lawliet206/ROS/frames.pdf

view_frames Result

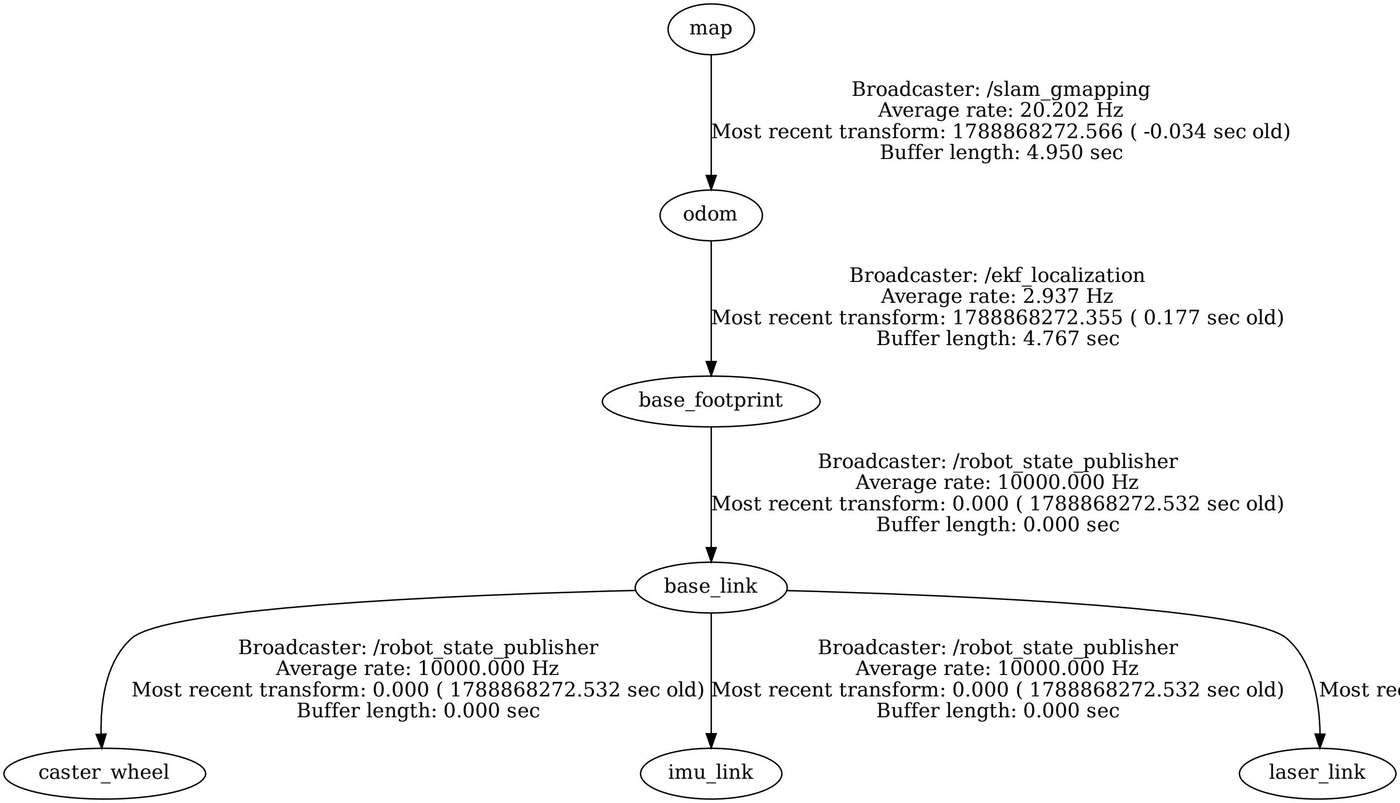
[picture p9: figure]
base_link; caster_wheel; Broadcaster: /robot_state_publisher Average rate: 10000.000 Hz; Buffer length: 0.000 sec; imu_link; laser_link; base_footprint; odom; Broadcaster: /ekf_localization Average rate: 2.937 Hz; Buffer length: 4.767 sec; map; Broadcaster: /slam_gmapping Average rate: 20.202 Hz; Buffer length: 4.950 sec

Most recent transform: 0.000 ( 1788868272.532 sec old)

Most recent transform: 0.000 ( 1788868272.532 sec old)

Broadcaster: /robot_state_publisher Average rate: 10000.000 Hz Most recent transform: 0.000 ( 1788868272.532 sec old) Buffer length: 0.000 sec

Most recent transform: 0.000 ( 1788868272.532 sec old)

Most recent transform: 1788868272.355 ( 0.177 sec old)

Most recent transform: 1788868272.566 ( -0.034 sec old)

Recorded at time: 1788868272.532
