lawliet206/ROS/硬件采购清单.md

# 两轮差速 ROS 机器人 — 硬件采购清单

> ⚠️ **注意：本文档为早期采购参考，部分内容已过时。**
> 电机驱动已从 **BTS7960 更换为 TB6612FNG**（3.3V 逻辑直连 ESP32，见 README「已解决」）；
> 下文架构图中的 BTS7960 请以 TB6612FNG 为准，采购清单已推荐 TB6612FNG。

## 架构概览

```
车载端:
  J1900 ──WiFi/网线──→ PC (你的笔记本, ROS Master)
      │
      └── USB ──→ 激光雷达 (USB转TTL)
      │
      └── USB ──→ ESP32
                        │
                        ├── PWM → TB6612FNG → 左电机 (带编码器)
                        ├── PWM → TB6612FNG → 右电机 (带编码器)
                        ├── PCNT ← 左/右编码器
                        └── I2C ← MPU6050 (IMU)
```

**分工：**
- **PC (ROS Noetic)**：SLAM (gmapping)、move_base 导航、人体跟随算法、ROS Master
- **J1900**：激光雷达驱动、串口桥接（收发 ESP32 数据）、WiFi 中继
- **ESP32**：电机 PID 控制、编码器读取、IMU 读取
- **TB6612FNG**：双路电机驱动（H 桥）

---

## 采购清单（按购买优先级排列）

### 1. 直流编码电机 ×2 【必买】

| 项目 | 规格 |
|---|---|
| 型号 | **JGB37-520** 直流减速电机（带霍尔编码器） |
| 电压 | 12V DC |
| 转速 | **1000 RPM**（对应减速比 **1:10**） |
| 编码器 | 霍尔编码器，AB 双相，**11 PPR**（6 线：电机正负 + 编码器电源正负 + A相 + B相） |
| 轴径 | **6mm D 型轴** |
| 转矩 | 电机本体 0.4 kg·cm × 减速比 10 = 输出轴 **4.0 kg·cm（0.39 N·m）**，够用 |
| 数量 | **2 个**（左右轮各一） |
| 预算 | **~120-160 元**（60-80 元/个） |

> 淘宝搜索词：`JGB37-520 编码电机 12V 1:10` 或 `JGB37-520 1000转`
>
> **务必确认：** ① 带霍尔编码器（11 PPR） ② 减速比 **1:10** ③ 输出轴 ~1000RPM ④ 6mm D 轴 ⑤ 转矩 0.4 kg·cm(电机本体)
> **速度：** 85mm 轮径 × 1000RPM = **4.45 m/s**，远超 2.38 要求。
>
> 常见店铺：龙盛五金、科智等，下单时跟客服确认以上 4 点。

---

### 2. 电机驱动模块 ×1 【必买】

JGB37-520 电机空载电流 ~200mA，堵转 ~2-3A，不需要大功率驱动。

**推荐：TB6612FNG 双路 H 桥 ~20-30 元**

| 项目 | 规格 |
|---|---|
| 型号 | **TB6612FNG** 双路 MOSFET H 桥模块（带底板） |
| 输入电压 | VM = 4.5V~13.5V（电机供电） |
| 逻辑电压 | VCC = 2.7V~5.5V（接 ESP32 3.3V） |
| 每路电流 | 1.2A 连续，峰值 3.2A |
| 控制 | AIN1/AIN2 + PWMA（左）, BIN1/BIN2 + PWMB（右） |
| 特点 | MOSFET 驱动，效率高、不发热、3.3V 直连 ESP32 |
| 数量 | **1 个**（一块驱动两个电机） |
| 预算 | **~20-30 元** |

> 淘宝搜索词：`TB6612FNG 电机驱动模块`
>
> **接线：** 与 L298N 完全相同（IN1/IN2 + PWM 控制），ESP32 固件通用。多一个 STBY 脚拉高到 3.3V 即可。
>
> **注意：** VM 最高 13.5V，3S 电池满电 12.6V，安全范围内。

---

### 3. 轮子 ×2 【必买】

| 项目 | 规格 |
|---|---|
| 类型 | 橡胶/硅胶轮胎 + 塑料/金属轮毂 |
| 直径 | **85mm**（附赠 6mm 黄铜联轴器。配 1:10 电机极速 4.45m/s） |
| 轮毂孔径 | **6mm**（联轴器直接套电机 D 轴） |
| 宽度 | 40-60mm |
| 数量 | **2 个** |
| 预算 | **~40-80 元**（20-40 元/个） |

> 淘宝搜索词：`机器人轮胎 85mm 6mm联轴器`
>
> **速度：** 85mm × 1000RPM(1:10) = **4.45 m/s** > 2.38 ✅
>
> **注意：** 轮径和减速比必须匹配代码，需要改三处：
> 1. **ESP32 固件**：`WHEEL_DIAMETER` → `0.085`，`GEAR_RATIO` → `10.0`
> 2. **serial_bridge**：启动加 `_wheel_dia:=0.085 _gear_ratio:=10.0`
> 3. **仿真 URDF**：`wheelDiameter` → `0.085`

---

### 4. 电池 ×1 【必买】

| 项目 | 规格 |
|---|---|
| 类型 | **3S 航模锂电池（LiPo）** |
| 标称电压 | 11.1V |
| 满电电压 | 12.6V |
| 容量 | **5200mAh ~ 6200mAh** |
| 放电倍率 | ≥25C（5200mAh × 25C = 130A，绰绰有余） |
| 接口 | **XT60 母头**（最通用） |
| 数量 | **1 块**（建议买 2 块，一块充一块用） |
| 预算 | **~100-140 元/块** |

> 淘宝搜索词：`3S 5200mAh 25C 锂电池 XT60`
>
> 常见品牌：Zeee、Ovonic、狮子（Lion Power）、富力。
>
> **续航计算：** 满速运行时电机 ~40W + J1900 5W + 雷达 2W ≈ 47W，11.1V 下 ~4.2A。5200mAh 可跑约 1 小时，远超 8 分钟要求。
>
> **还需要配充电器：**
> - 入门平衡充：**B3 充电器**（20W，慢但便宜）~25 元
> - 推荐平衡充：**B6AC**（80W，带屏幕，多功能）~80 元
> - 淘宝搜 `B6AC 平衡充电器`

> **安全提醒：** 锂电池禁止过充（>4.2V/片）和过放（<3.3V/片）。ESP32 代码里我会加上电压检测和低压报警。充电时人不要离开。

---

### 5. ESP32 开发板 ×1 【必买】

| 项目 | 规格 |
|---|---|
| 型号 | **ESP32-WROOM-32** 开发板（CP2102 或 CH340 串口芯片均可） |
| 主频 | 240MHz 双核 |
| 引脚 | 30 脚或 38 脚均可 |
| 接口 | Micro USB |
| 数量 | **1 块** |
| 预算 | **~20-35 元** |

> 淘宝搜索词：`ESP32 开发板 CP2102` 或 `ESP32-WROOM-32`
>
> 推荐店铺：安信可（原厂）、合宙。买最便宜的开发板即可，不用买带屏幕/摄像头的版本。

---

### 6. IMU 模块 ×1 【必买】

| 项目 | 规格 |
|---|---|
| 型号 | **MPU6050**（6 轴：3 轴加速度 + 3 轴陀螺仪） |
| 接口 | I2C |
| 电压 | 3.3V ~ 5V |
| 数量 | **1 个** |
| 预算 | **~8-15 元** |

> 淘宝搜索词：`MPU6050 模块 GY-521`
>
> 买 GY-521 紫色/蓝色小板即可，最通用。

---

### 7. 降压模块 ×2 【必买】

| 项目 | 规格 |
|---|---|
| 类型 | **DC-DC 可调降压模块** |
| 型号 | LM2596 或 Mini-360（MP1584） |
| 输入 | 4.5V ~ 28V |
| 输出 | 可调，设定为 5V |
| 电流 | ≥3A |
| 数量 | **2 个**（1 个给 J1900 供电，1 个给 ESP32 + 雷达供电） |
| 预算 | **~10-20 元**（5-10 元/个） |

> 淘宝搜索词：`LM2596 降压模块` 或 `mini360 降压模块`
>
> Mini-360 更小更便宜（~3 元/个），但需要焊线。LM2596 带螺丝端子，接线方便。

---

### 8. 底盘材料 【必买】

| 项目 | 规格 |
|---|---|
| 方案 | **亚克力板 双层**，厚 4-5mm，淘宝激光切割 ~40 元 |
| 下层 | **200×160mm**：电机 + 牛眼轮 + 电池 |
| 上层 | **180×140mm**：TB6612FNG + ESP32 + 激光雷达 + J1900 |
| 连接 | 四角 M3 双通铜柱 50mm 连接上下层 |

> 提供 DXF 图纸（`tools/generate_dxf.py` 生成），发给店家即可。
> 淘宝搜索词：`亚克力板定制 激光切割`

---

### 9. 万向从动轮 ×1 【必买】

| 项目 | 规格 |
|---|---|
| 类型 | 金属牛眼轮或小型万向轮 |
| 直径 | 25-40mm（需要垫高到与底盘齐平，底盘 ~5cm 高） |
| 安装 | 螺丝 + **14mm 铜柱垫高**（底盘底面 42.5mm - 牛眼轮 29mm = 差 13.5mm，用 10+4mm(螺母) 铜柱凑） |
| 数量 | **2 个**（车头 1 个，车尾底面 1 个） |
| 预算 | **~10-30 元**（2 个） |

> 淘宝搜索词：`金属牛眼轮 M3`
>
> **你的牛眼轮高 29mm，底盘底面离地 42.5mm，需要用铜柱垫高 14mm。**

---

### 10. 接线配件 【必买】

| 项目 | 规格 | 预算 | 用在哪儿 |
|---|---|---|---|
| 14AWG 硅胶线 红/黑 各 1 米 | 裸线无接头，自己剪长度，焊 XT60 或拧 BTS7960 螺丝端子 | ~10 元 | 电池→开关→BTS7960（大电流） |
| XT60 公头 ×3 | 焊在 14AWG 线端。公头=金属柱外露，接用电设备端 | ~8 元 | BTS7960 电源输入 ×1，降压模块输入 ×1，充电器线 ×1 |
| XT60 母头 ×1 | 焊在 14AWG 线端。母头=孔藏里面，接电池端（电池自带则不用） | ~3 元 | 电池延长线（如需） |
| XT60 一分二并联线 ×1 | 成品线，一头母接电池，分出两个公头 | ~8 元 | 电池一分二：一路→开关→BTS7960，一路→降压模块 |
| 电源开关（带 XT60） ×1 | 串联在电池和 TB6612FNG 之间，关掉即整车断电（不含 J1900/ESP32） | ~10 元 | 电池→开关→TB6612FNG VM |
| 杜邦线 公母 各 20 根 | 预压好插头的信号线，直接插 ESP32/BTS7960 排针 | ~5 元 | 全部信号线：PWM、编码器、I2C |
| 电机固定支架 ×2 | L 型 或 U 型，M3 安装孔 | ~10 元 | 固定 JGB37-520 到板子边缘 |
| 电阻 10kΩ + 1kΩ ×1 套 | 1/4W 碳膜，引脚直插焊接 | ~1 元 | 电池分压电路（电池正→10k→GPIO34→1k→GND） |
| 排针 + 排母 各 1 排 | 2.54mm 间距，焊在 ESP32/驱动板信号口 | ~5 元 | ESP32 GPIO 引出，BTS7960 信号口引出 |
| 热缩管套装 | 各种粗细 | ~5 元 | 包焊点/接线处，绝缘 |
| 尼龙扎带 | 3×100mm | ~3 元 | 线束整理 |
| 3M 双面胶/魔术贴 | 宽 20mm | ~5 元 | 电池固定，MPU6050 固定 |
| M3 双通铜柱套装 | **双通** 6/10/15/20mm + **50mm×4**（连接上下层用）+ M3×10mm 螺丝 30 个 + M3 螺母 20 个 | ~16 元 | 板卡固定 + 双层连接 |
| M3 平垫片 ×20 个 | 外径 7mm，内径 3.2mm | ~3 元 | 螺丝头夹住板子，不会从 5mm 孔滑脱 |
| PH2.0 4P 转杜邦母头 ×2 | 编码器信号线，4P 头插电机排针2/3/4/5（Vcc/A/B/GND） | ~6 元 | 电机编码器 → ESP32 GPIO |
| USB Micro 数据线 ×1 | 必须数据线（4 芯），不能是充电线（2 芯） | ~8 元 | J1900 USB → ESP32 Micro USB |
| **合计** | | **~110 元** |

> **铜柱安装方式（板孔 5mm > 螺丝 3mm，必须垫片！）：**
> ```
>   [板卡]           ← ESP32 / BTS7960
>    ↕ M3 短螺丝
>   [铜柱 双通]
>    ↕ M3×10mm 螺丝
>   [垫片]            ← 外径 7mm > 板孔 5mm
>   [===亚克力板===]
> ```
> 螺丝从下往上穿：螺丝头→垫片→5mm板孔→铜柱。垫片夹紧，不会滑脱。

---

### 11. 激光雷达（先测试 lab 给的）【条件购买】

如果 lab 的雷达是坏的，需要自己买：

| 型号 | 说明 | 价格 |
|---|---|---|
| **YDLIDAR X4** | 10m 测距，360°，ROS 驱动成熟 | ~400 元 |
| **RPLIDAR A1M8** | 12m 测距，360°，ROS 驱动成熟 | ~450 元 |
| 二手 YDLIDAR X2/X4 | 闲鱼上可能有，便宜但风险 | ~200-300 元 |

> 淘宝搜索词：`YDLIDAR X4 激光雷达` 或 `思岚 A1M8`
>
> YDLIDAR X4 性价比更高，驱动成熟，文档齐全。

---

### 12. USB 摄像头（人体跟随用）【可选，先不买】

| 项目 | 规格 |
|---|---|
| 类型 | USB 免驱摄像头 |
| 分辨率 | ≥640×480 |
| 帧率 | ≥30fps |
| 视角 | ≥70° |
| 预算 | **~50-80 元** |

> **策略：** 先用纯激光雷达做人体跟随（不花钱），效果不好再买摄像头做视觉融合。
>
> 淘宝搜索词：`USB摄像头 免驱 广角`

---

## 总预算汇总

| 类别 | 项目 | 金额 |
|---|---|---|
| **必买** | 编码电机 ×2 | 120-160 元 |
| **必买** | TB6612FNG 驱动 | 20-30 元 |
| **必买** | 轮子 ×2 | 40-80 元 |
| **必买** | 3S 锂电池 | 100-140 元 |
| **必买** | B6AC 充电器 | 80 元 |
| **必买** | ESP32 | 20-35 元 |
| **必买** | MPU6050 IMU | 8-15 元 |
| **必买** | 降压模块 ×2 | 10-20 元 |
| **必买** | 底盘 + 牛眼轮 ×2 | 40-75 元 |
| **必买** | 接线配件 | 110 元 |
| | **必买小计** | **~564-766 元** |
| **条件** | 激光雷达（lab 坏时） | 400-450 元 |
| **可选** | USB 摄像头 | 50-80 元 |
| | **最高总计** | **~995-1267 元** |

---

## 省钱的极限方案（去掉摄像头、lab 雷达能用）

**最低花费约 564 元**，就能跑通全部基本任务（建图 + 导航 + 纯激光人体跟随）。

---

## 核对清单（下单前逐项确认）

- [ ] 电机：确认 1000RPM（输出轴）、带霍尔编码器（11 PPR）、减速比 1:10、6mm D 轴
- [ ] 轮子：确认 85mm，附赠 6mm 联轴器
- [ ] 电池：确认 3S XT60 接口
- [ ] 充电器：确认支持 3S 锂电池平衡充
- [ ] ESP32：确认是 CP2102 或 CH340 串口芯片
- [ ] 降压模块：确认输入电压范围覆盖 11.1V（至少 15V 以上耐压）
- [ ] BTS7960：确认是双路红色 PCB
- [ ] XT60 接头数量配对（电池 1 母 + 驱动端 1 公，充电器端看充电器接口）
- [ ] XT60 一分二并联线 + 电源开关（不要省，安全第一）
- [ ] USB 线是数据线，不是充电线

---

## 电压安全红线（必读！烧了不赔）

**每个元件能承受的最高电压：**

| 元件 | 供电电压 | 信号电压 | 超过会怎样 |
|---|---|---|---|
| ESP32 GPIO | 3.3V（Vin 可接 5V） | **≤3.3V** | **烧 GPIO，板子报废** |
| ESP32 Vin 脚 | **5V**（从降压模块来） | — | >6V 烧稳压芯片 |
| MPU6050 VCC | 3.3V | 3.3V（I2C 上拉） | >3.6V 烧传感器 |
| TB6612FNG VM (电机供电) | **12V**（电池直连） | — | >13.5V 烧模块（电池满电12.6V安全） |
| TB6612FNG VCC (逻辑) | 3.3V | 3.3V | 接 ESP32 3.3V 输出 |
| 编码器 Vcc | **3.3V**（来自 ESP32） | **≤3.3V** | 接 5V 信号→烧 ESP32 GPIO |
| J1900 电源 | **5V** 或 **12V**（看具体型号） | — | 超压烧主板 |
| 激光雷达 | **5V**（来自降压模块） | — | 看型号说明 |

**铁律：**
1. **降压模块必须先调到 5V 再接负载！** 用万用表测好再接，默认输出电压可能不是 5V
2. **编码器只接 ESP32 3.3V，绝不接 5V！** 否则 A/B 信号线出 5V 烧 ESP32
3. **所有 GND 必须连在一起**（电池负 = TB6612FNG GND = ESP32 GND = 编码器 GND = 降压模块 GND = J1900 GND）
4. **14AWG 线只有电池→BTS7960 和 BTS7960→电机这两段用**，信号线全部杜邦线
5. **上电前万用表测：** 降压模块输出=5V，BTS7960 B+/B- 极性正确，所有焊点无短路

---

## 组装顺序与接线指南

### 第 1 步：机械组装（最优先，1-2 小时）

```
底盘（亚克力/铝板）
  ├── 电机 ×2 → L 型支架固定到底盘底部/侧面
  │     ├── 左电机：车体左侧，轴朝外（Y 正方向）
  │     └── 右电机：车体右侧，轴朝外（Y 负方向）
  ├── 轮子 ×2 → 套上电机 D 轴（6mm），可能需要联轴器
  ├── 前万向轮 → 底盘前方底部，用铜柱垫高到刚好触地
  ├── 后万向珠 → 底盘后方底面，用网格孔或双面胶固定
  │     └── 底盘高 ~5cm，牛眼轮 + 铜柱总高需凑满 5cm
  └── 激光雷达 → 底盘顶面前方/中央，螺丝或双面胶固定

组装完成后手动推车，确认：
  - 两轮着地 + 前后万向轮着地，车不摇晃
  - 轮子能自由转动，无卡滞
  - 雷达水平安装，不倾斜
```

### 第 2 步：电源系统接线（先不接其他模块）

> **⚠️ 安全第一**：焊线或接线时电池必须断开！

```
电池 (XT60 母头)
  │
  └── XT60 一分二并联线
        ├── 电源开关 → L298N VCC (12V输入)
        │     L298N VCC 接开关后电池正极
        │     L298N GND 接电池负极
        │
        └── 降压模块1 → 调至 5V（J1900 需 ≥3A，LM2596 会过热，推荐 Mini560 或 5A 模块）
              ├── 输入 + → 电池正极
              ├── 输入 - → 电池负极
              ├── 输出 +5V → J1900 供电
              └── 输出 GND → J1900 GND

降压模块2 → 调至 5V 输出（给 ESP32 + 雷达，~1A 足够）
  ├── 输入 + → 电池正极（与模块1并联）
  ├── 输入 - → 电池负极
  ├── 输出 +5V → ESP32 Vin（或通过 Micro USB）
  ├── 输出 +5V → 激光雷达供电（如需）
  └── 输出 GND → 共地

确认万用表测降压模块输出 = 5.0V ± 0.2V

电池电压检测分压电路（焊接在 ESP32 附近）：
  电池正极 ──→ 10kΩ ──┬──→ ESP32 GPIO 34 (ADC)
                       │
                      1kΩ
                       │
                      GND
  分压比 1/11，12.6V 满电时 ADC 读到 ~1.15V（安全）
```

### 第 3 步：电机 + 驱动接线

```
TB6612FNG 接线：
  VM ──── 电池正极（经开关，电机供电）
  VCC ───→ ESP32 3.3V（逻辑供电）
  GND ──── 电池负极（共地）
  AOUT1/AOUT2 ──→ 左电机 正极/负极
  BOUT1/BOUT2 ──→ 右电机 正极/负极
  STBY ──→ ESP32 3.3V（拉高使能）

ESP32 → TB6612FNG 信号线：
  GPIO 25  ──→ AIN1（左电机方向1）
  GPIO 26  ──→ AIN2（左电机方向2）
  GPIO 15  ──→ PWMA（左电机速度）
  GPIO 32  ──→ BIN1（右电机方向1）
  GPIO 33  ──→ BIN2（右电机方向2）
  GPIO 16  ──→ PWMB（右电机速度）
  GND       ──→ GND（共地！）

控制逻辑（与 L298N 相同）：
  AIN1=H, AIN2=L, PWMA=PWM → 正转
  AIN1=L, AIN2=H, PWMA=PWM → 反转

> 如果电机转的方向反了，交换电机两根线（OUT+ 和 OUT-）即可。
```两个电机完全一样，靠安装位置区分。站在车后面，面朝车头：

你左手边 → 左电机（装在板子 Y≈22 的边缘）→ 编号 M1-M4
你右手边 → 右电机（装在板子 Y≈228 的边缘）→ 编号 M5-M8

### 第 4 步：编码器接线

```
JGB37-520 编码器出线（6 针排线，从左到右）：
  1. 电机电源+（粗红）  → BTS7960 M+
  2. 编码器 Vcc         → ESP32 3.3V（别接 5V，否则信号可能烧 ESP32）
  3. A 相（信号）        → 左电机 GPIO 27 / 右电机 GPIO 4
  4. B 相（信号）        → 左电机 GPIO 14 / 右电机 GPIO 13
  5. 编码器 GND          → ESP32 GND
  6. 电机电源-（粗黑）  → BTS7960 M-

> 第 2 针供电务必接 3.3V，不要接 5V。
> 两个电机排线相同，用标签区分左右。
```

### 第 5 步：MPU6050 接线

```
MPU6050 (GY-521) → ESP32：
  VCC  ──→ 3.3V
  GND  ──→ GND
  SCL  ──→ GPIO 22（I2C 时钟）
  SDA  ──→ GPIO 21（I2C 数据）

> 安装在车体前上方，尽量水平。用双面胶或铜柱固定。
```

> 编码器电源接 5V（不是 3.3V），信号线直接接 ESP32（3.3V 兼容）。
> 颜色可能因厂家不同而不同，以上电后手动转动轮子，用串口监视器看输出为准。
```

### 第 5 步：MPU6050 接线

```
MPU6050 (GY-521) → ESP32：
  VCC  ──→ 3.3V
  GND  ──→ GND
  SCL  ──→ GPIO 22（I2C 时钟）
  SDA  ──→ GPIO 21（I2C 数据）

> 安装在车体前上方（imu_link 位置），尽量水平。
> 安装高度：底盘上方 2-6cm。用双面胶或铜柱固定。
```

### 第 6 步：首次上电测试（轮子悬空！）

```
1. 车轮架起来（悬空）
2. 万用表确认 BTS7960 B+/B- 电压 = 电池电压（~11-12V）
3. 电池上电 → ESP32 亮灯
4. PC 打开串口监视器（Arduino IDE 串口监视器，115200 baud）
5. 应该看到 "ESP32 READY" 和定期的 "e..." "i..." 数据输出
6. 串口监视器发送（带 XOR 校验和，末尾两位是校验码）：
   发送: m 30 30 6D   → 两轮应正转 30 RPM
   发送: m 0 0 6D     → 停车
   发送: m -30 -30 X  → 两轮反转（校验和需重算，建议用 serial_bridge 发 /cmd_vel 替代手工测试）
7. 手动转动轮子，看串口 "e L_enc R_enc" 数据变化
8. 晃动 IMU，看 "i ax ay az gx gy gz" 数据变化
9. 全部正常 → 断电 → 轮子着地 → 继续第 7 步
```

### 第 7 步：J1900 + 激光雷达

```
1. USB 数据线：ESP32 ──USB──→ J1900（/dev/ttyUSB1）
2. USB 数据线：激光雷达 ──USB──→ J1900（/dev/ttyUSB0）
3. J1900 供电：降压模块输出 → J1900

SSH 到 J1900 验证：
  ls /dev/ttyUSB*     # 应该看到 ttyUSB0 和 ttyUSB1

启动串口桥接：
  source ~/catkin_ws/devel/setup.bash
  rosrun rosserial_python serial_node.py _port:=/dev/ttyUSB1 _baud:=460800

启动激光雷达（YDLIDAR X4 为例）：
  source ~/catkin_ws/devel/setup.bash
  roslaunch ydlidar_ros X4.launch
```

### 第 8 步：PC 端软件启动

步骤见 `2.txt` 或 `SETUP.md` 第 4 节。

### 接线速查图

```
                        电池 11.1V (XT60)
                              │
                    ┌─────────┴─────────┐
                    │   XT60 一分二      │
                    └──┬──────────────┬──┘
                       │              │
                  [电源开关]    [降压模块1]     [降压模块2]
                       │         5V→J1900       5V→ESP32+雷达
                 TB6612FNG
                 ┌───┴───┐
                 │VM VCC │──→ 电池12V / ESP32 3.3V
                 │STBY   │──→ 3.3V (拉高)
                 │AOUT1/2│──→ 左电机
                 │BOUT1/2│──→ 右电机
                 │AIN/BIN│──→ ESP32 GPIO 25,26,32,33
                 │PWMA/B │──→ ESP32 GPIO 15,16 (PWM)
                 └───────┘

        ESP32 ─── I2C(21,22) ─── MPU6050
              ─── GPIO 27,14 ─── 左编码器 A,B
              ─── GPIO 4,13 ─── 右编码器 A,B
              ─── GPIO 25,26 ─── TB6612 AIN1,AIN2 (左)
              ─── GPIO 32,33 ─── TB6612 BIN1,BIN2 (右)
              ─── GPIO 15,16 ─── TB6612 PWMA,PWMB
              ─── USB ─── J1900 (/dev/ttyUSB1)

        激光雷达 ─── USB ─── J1900 (/dev/ttyUSB0)

        J1900 ─── WiFi ─── PC (ROS Master)
```

---

## 底盘孔位编号与连线走法

板子 300×250mm，X 向前（车头），Y 向侧。原点 (0,0)=左下角。所有安装孔 **5mm**，走线孔 **10mm**。

```
                    ← Y=250 板子右边缘 →
  ┌──────────────────────────────────────────┐
  │ M5         右电机           M8          │ ← 右电机: M5 M6 M7 M8
  │ M6          Y=228          M7          │   轴向左伸出, 轮在板外侧
  │                                          │
  │  W2            L2──L1                   │ ← L1-L4: 激光雷达 30mm方
  │                │    │                   │
  │  C1──C2  W2    L3──L4       C4──C3     │ ← C1-C4: 万向轮 20mm方
  │  (前)                                   │
  │     G..G..G..G..G..G                    │ ← 6×6网格 5mm孔
  │     G..G..G..G..G..G                    │
  │  E1──E2 G..G..G..G..G..G              │ ← E1-E2: ESP32
  │     G..G..G..G..G..G                    │
  │ B1──B2 G..G..G..G..G..G              │ ← B1-B4: BTS7960 45×35mm
  │ │    │ G..G..G..G..G..G              │
  │ B3──B4 G..G..G..G..G..G              │
  │                                          │
  │  W3            S1 ██ S2                 │ ← S1 S2: 电池绑带槽
  │                                          │
  │ M1         左电机           M4          │ ← M1-M4: 左电机 29mm方
  │ M2          Y=22           M3          │   轴向右伸出, 轮在板外侧
  │  W1                                     │
  └──────────────────────────────────────────┘
  ↑ X=0                              X=300 ↑
    后                                      前
```

### 孔位坐标表

| 编号 | (X,Y) | 安装 | 说明 |
|---|---|---|---|
| **M1-M4** | (135.5,7.5) (164.5,7.5) (164.5,36.5) (135.5,36.5) | 左电机 | 29mm 正方 |
| **M5-M8** | (135.5,213.5) (164.5,213.5) (164.5,242.5) (135.5,242.5) | 右电机 | 同上 |
| **C1-C4** | (260,115) (280,115) (280,135) (260,135) | 前万向轮 | 20mm 正方 |
| **B1-B4** | (57.5,42.5) (102.5,42.5) (102.5,77.5) (57.5,77.5) | BTS7960 | 45×35mm |
| **E1-E2** | (197.5,60) (242.5,60) | ESP32 | M3 铜柱 |
| **L1-L4** | (150,110) (180,110) (180,140) (150,140) | 激光雷达 | 30mm 正方 |
| **W1** | (150,40) | 左电机走线 | 10mm 大孔 |
| **W2** | (150,210) | 右电机走线 | 10mm 大孔 |
| **W3** | (80,200) | 电源走线 | 10mm |
| **U1** | (40,120) | ESP32 USB 穿线 | 15mm |
| **U2** | (260,200) | 激光雷达 USB 穿线 | 15mm |
| **U3** | (40,200) | 备用穿线 | 15mm |
| **Z1-Z4** | (100,50)(100,90)(200,150)(230,80) | 扎带固定槽 | 8×4mm |
| **S1** | (70,70)→(85,180) | 电池绑带槽1 | 15×110mm |
| **S2** | (120,70)→(135,180) | 电池绑带槽2 | 15×110mm |
| **G** | 左/中/右三块规整网格 | 扩展孔 | 5mm |

### 轮子怎么装

电机用 L 型支架或直接螺丝固定在板子侧边缘（M1-M8 孔），**电机轴朝外伸**，轮子套在轴上。轮子在板子外面，板上不需要开轮孔。

```
    板子左边缘 (Y≈22)          板子右边缘 (Y≈228)
    ┌────板子────┐            ┌────板子────┐
    │            │            │            │
    │  M1──M4    │            │    M5──M8  │
    │  电机      │            │    电机    │
    │  ←轴伸出   │            │    轴伸出→ │
    │  轮子在    │            │    轮子在  │
    │  板子外侧  │            │    板子外侧│
    └────────────┘            └────────────┘
```

### 连线走法

```
[电池] XT60 → 一分二
  ├→ 开关 → L298N VCC/GND
  └→ 降压1(5V→J1900)  | 降压2(5V→ESP32+雷达)
                         └→ 线走 W3 穿板上层

[左电机] 针1(粗红)→L298N OUT1 | 针6(粗黑)→L298N OUT2  ─→ 经 W1 穿板
         针3(A相)→GPIO27 | 针4(B相)→GPIO14 | 针2(Vcc)→3.3V 针5(GND)→GND → 经W1

[右电机] 针1(粗红)→L298N OUT3 | 针6(粗黑)→L298N OUT4  ─→ 经 W2 穿板
         针3(A相)→GPIO4 | 针4(B相)→GPIO13 | 针2(Vcc)→3.3V 针5(GND)→GND → 经W2

[ESP32→L298N 信号线, E区→B区]
  GPIO 25 → IN1 (左方向1)
  GPIO 26 → IN2 (左方向2)
  GPIO 15 → ENA (左速度 PWM)
  GPIO 32 → IN3 (右方向1)
  GPIO 33 → IN4 (右方向2)
  GPIO 16 → ENB (右速度 PWM)
  GND ──→ L298N GND

[MPU6050] 双面胶贴底盘前端上方 (C区附近)
  VCC→3.3V  GND→GND  SDA→GPIO21  SCL→GPIO22

[电池分压] W3(80,200) 附近
  电池正 → 10kΩ → GPIO34 → 1kΩ → GND
```
