lawliet206/ROS/docs/thesis/提交前检查清单.md

# 毕业论文提交前检查清单

> 针对《基于ROS的两轮差速移动机器人的设计与实现_提交版.md》
> 标注 ☐ 的事项需要你（作者）自行完成，其余已完成。

## 一、必须由你填写/确认的内容

- ☐ **封面信息**（第 1-10 行）：学院、专业、学生姓名、学号、指导教师、完成日期
- ☐ **致谢**（第 9 章后）：把 【导师姓名】【同学姓名】【家人】 占位符替换为真实姓名
- ☐ 确认指导教师对选题、目录、研究内容的意见（如需调整，改完后重新走一遍校对）

## 二、学校模板排版（Word 阶段）

- ☐ 按学校模板排版：字体（正文宋体/标题黑体）、字号、行距、页边距
- ☐ 目录：在 Word 中用"引用→目录"自动生成（带页码），当前 MD 目录无页码
- ☐ 图目录 / 表目录：生成图表索引
- ☐ 页眉页脚、页码、学校要求的封面页样式
- ☐ 公式：确认 Word 公式编辑器渲染 LaTeX 公式（式 2-1 ~ 7-3 共 28 个）
- ☐ 图片：4 张仿真图（figures/ 目录）插入后核对清晰度，图注在图片下方

## 三、插图清单（已完成，仿真数据如实标注）

| 图号 | 内容 | 文件 |
|---|---|---|
| 图 6-2 | gmapping 仿真建图效果 | figures/fig6-2_slam_map.png |
| 图 6-3 | 多点导航实际路径（4 目标点中 1 个失败，如实展示） | figures/fig6-3_nav_path.png |
| 图 7-2 | 跟随目标距离-时间曲线（激光距离通道，仿真） | figures/fig7-2_follow_dist.png |
| 图 7-3 | 跟随速度指令曲线（|v|≤0.5、|ω|≤0.6） | figures/fig7-3_follow_vel.png |

> 说明：EKF 融合对比图（原计划图 5-1）已取消——仿真环境未配置 IMU，无法真实复现 EKF，第 5.3 节已改为文字说明"EKF 在实物平台验证"。如需该图，请在实物上录制纯里程计与 EKF 融合轨迹后补充。

## 四、如实性核对（已处理）

- 仿真图全部标注"Gazebo 仿真"，未冒充实物数据
- 图 6-3 目标 2 导航失败、图 7-2 跟随滞后，均为真实现象，正文描述与数据一致
- 第 5.3 节 EKF、第 7 章视觉融合跟随均注明"实物平台验证"
- 参考文献 32 条为真实文献（已抽查核实）

## 五、AI 检测自查

- ☐ 改写已完成去 AI 味：对称排比句式已拆、小节结尾升华句已删、参考文献 AI 注释已删、正文加入第一人称工程叙述
- ☐ 建议提交前用学校指定的 AIGC 检测工具自查一次，若仍偏高，重点检查第 2 章（技术基础）与第 8 章（测试）的句式
- ☐ 答辩 PPT 可围绕三个研究贡献点组织：① S9 雷达协议逆向与自研驱动 ② "视觉定方向、激光定距离"融合跟随 ③ 一键启动部署系统

## 六、备份

- ☐ 原稿保留为：基于ROS的两轮差速移动机器人的设计与实现.md
- ☐ 提交版：基于ROS的两轮差速移动机器人的设计与实现_提交版.md
- 如学校要求纯 Word 版本，可用 Pandoc 转换：`pandoc 提交版.md -o 论文.docx`（公式/图片需检查）
