lawliet206/ROS/(commit log)

2026-07-15 init: ROS 两轮差速机器人项目初始提交
    两轮差速 ROS 机器人项目，ROS Noetic。
    包含实物包 (robot_bringup)、仿真包 (robot_sim)、
    ESP32 下位机固件 (PCNT 编码器 + PID + rosserial)、
    工具脚本和硬件采购清单。
    [robot.urdf, robot_sim.urdf]
2026-07-15 Update wheel track width from 135mm to 180mm
2026-07-15 fix: 轮距统一为 180mm + ESP32 硬件看门狗
    - README: 135mm → 180mm（固件/URDF/launch 原本就是 180mm）
    - README: 取消需用户确认状态
    - ESP32 固件: 添加 esp_task_wdt 硬件看门狗（5s 超时自动重启）
    - esp_task_wdt_init(5, true)
    - esp_task_wdt_add(NULL)
    - esp_task_wdt_reset() 在主循环入口喂狗
    [esp32_firmware.ino]
2026-07-15 clean: serial_bridge.py 停止在 CMake 中安装
    该脚本已被 rosserial 取代，不再需要安装到系统路径
2026-07-15 clean: 删除所有死代码
    删除文件:
    - src/robot_sim/scripts/wheel_controller.py (仿真用 Gazebo diff_drive 插件)
    - src/robot_bringup/scripts/serial_bridge.py (已被 rosserial 取代)
    - EXAMPLES.md / README.zh.md (Karpathy 模板，非本项目文档)
    清理引用:
    - bringup.launch: 移除 serial_bridge 节点和 start_bridge 参数
    - ekf/slam/follow/navigation.launch: 移除 start_bridge 参数传递
    - slam_start.sh / nav_start.sh: 注释更新
    - ekf.yaml: 注释更新
    - README: 项目结构/状态同步
2026-07-15 fix: package.xml 添加 robot_localization 依赖
2026-07-15 feat: IMU 输出稳定化（零偏校准 + 低通滤波 + 姿态输出）
    改动:
    - 启动时 calibrate_gyro(): 采样 200 次取平均，标定陀螺零偏
    - read_imu() 中加入 IIR 低通滤波 (α=0.15)
    - 陀螺仪读数减去零偏后再滤波
    - 从加速度计计算 roll/pitch 并输出 orientation
    - 协方差从 0.01 改为 0.005（滤波后更稳定）
    - README 添加 robot_localization 安装说明
2026-07-15 feat: 添加 MPU6050 稳定性测试固件（低通滤波 + 零偏校准）
2026-07-15 feat: add complementary filter + roll normalization + IMU init pre-read
2026-07-16 feat: LD2402 毫米波雷达人体跟随 + 速度参数优化 + 编码器方向修正
    - 新增 radar_follower.py: LD2402 雷达人体跟随节点 (含丢失旋转搜索)
    - follow.launch: 支持 sensor:=laser / sensor:=radar 切换
    - esp32_firmware.ino: PCNT filter 1500→250, ENC_RIGHT_DIR=-1,
    MAX_CMD_RPM=1200, PID_OUTPUT_LIMIT=1023, 左轮 IN1/IN2 交换
    - esp32_board_test.ino: 同主固件参数, 移除 ROS 依赖
    - README/SETUP: 更新架构图、LD2402 接线、跟随启动说明
    [esp32_board_test.ino, esp32_firmware.ino]
2026-07-17 feat: 激光+毫米波融合跟随 + 多项核心修复
    新功能:
    - fusion_follower.py: 激光角度 + 毫米波距离融合跟踪
    - ld2402_publisher.py: LD2402 纯数据发布节点
    - sim_radar.py + sim_follow_radar.sh: LD2402 仿真模拟
    - radar_follower: EMA距离滤波 + sim_mode话题模式
    - kill_ros.sh: 一键关闭所有ROS进程
    核心修复:
    - bringup.launch: eval表达式修复, 雷达无法启动
    - send_goals.py: JSON格式 _goals:=[[]] 替代错误元组格式
    - laser_follower: 丢目标后刹车 + locked 重置
    - fusion_follower: 雷达数据超时, LD2402断连后车继续走
    - slam/navigation.launch: 内嵌EKF, 解odom-base_footprint TF断链
    - robot_sim CMakeLists: 移除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
    [laser_follower.py, lidar_display.py, lidar_scan_pub.py, lidar_sdk_driver.py, lidar_view.py, s9_lidar_driver.py]
2026-07-17 docs: SETUP.md 添加 kill_ros 清理脚本 + source 提示
2026-07-17 feat: IMU激光去畸变 + EKF加速度轴修正 + IMU URDF朝向修正
    新增:
    - scan_deskew.py: 用 IMU ω_z 补偿扫描过程中的机器人旋转
    - slam.launch: deskew 开关 + relay, gmapping 始终读 /scan_deskewed
    修正:
    - ekf.yaml: 加速度轴 ax→ay (IMU Y轴=车头前进方向)
    - robot.urdf: imu_joint 加 rpy 旋转 (IMU Y→车头, X→右, Z→上)
    文档:
    - SETUP.md: 补齐 source 提示 + kill_ros 清理脚本
    [robot.urdf]
2026-07-18 feat: LD2402 ASCII测试脚本 + SETUP更新
    - tools/ld2402_test.py: LD2402纯ASCII解析,独立测试工具
    - SETUP.md: 补充leg_tracker/网络配置/实物操作步骤
2026-07-18 fix: LD2402纯ASCII解析 + 融合策略重构
    - ld2402_publisher: 删掉二进制帧解析(F4F3F2F1), 改为按行解析 distance:XXX
    - fusion_follower: 雷达只做门控(有人/无人), 激光负责实际跟踪
    无人时搜索: 左转2.5s → 右转5s → 永停
2026-07-18 refactor: ld2402_publisher 移除不可靠的距离发布, 只保留 presence Bool
    - ld2402_publisher.py: 简化为只发布 /radar_presence (Bool)
    - ld2402_calibrate.py: 新增背景噪声学习工具
    - ld2402_config.py: 新增硬件参数读写工具 (LD2410 协议兼容)
    - fusion_follower.py 已提前适配 (只读 /radar_presence)
2026-07-19 refactor: ESP32固件加调参注释, 移除微波雷达, 修复仿真脚本
    - esp32: 所有可调参数添加注释 (机械/PID/IMU/看门狗/堵转/协方差)
    - 删除所有微波雷达相关代码 (publisher/follower/fusion/工具/sim)
    - follow.launch 简化为纯激光模式
    - sim_navigation/sim_slam: 修复 roslaunch 卡清理步骤 (timeout + unset ROS_MASTER_URI)
    [esp32_firmware.ino]
2026-07-19 docs: SETUP/README 移除所有微波雷达内容
2026-07-20 docs: SETUP 添加 SSH 免密登录和 ROS 主从配置步骤
2026-07-20 fix: CMakeLists 移除已删除的雷达脚本引用
2026-07-22 feat: 激光跟随加人体宽度约束(0.15~0.55m) + 连续锁定检测
2026-07-22 fix: 右电机BO1/BO2接线反 → 交换IN1/IN2
    [esp32_board_test.ino, esp32_firmware.ino]
2026-07-28 fix: 降低最大速度(200RPM/0.89m/s)+放宽堵转检测+board_test调试输出
2026-07-28 fix: IMU帧旋转+EKF对齐+EMA平滑+线程安全+脚本健壮性
    固件 (esp32_firmware.ino):
    - IMU frame_id: imu_link → base_link, 添加 R_z(π/2) 旋转
    - 互补滤波 accel_roll: 修正 Z 轴符号 (atan2(-ay, az))
    - 校准段 cf_roll 初始化和主循环公式保持一致
    EKF (ekf.yaml):
    - odom y 改为 false (差速车无法横移)
    - IMU ax 改为 true (前进加速度, 对齐固件帧旋转)
    跟随 (laser_follower.py):
    - 添加角度 EMA 平滑, 锁定瞬间初始化避免冷启动滞后
    - 移除未使用的 target_angle 变量
    去畸变 (scan_deskew.py):
    - 添加 threading.Lock 保护 IMU 缓冲区线程安全
    雷达驱动 (s9_lidar_driver.py + tools/lidar_*):
    - 移除 sudo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
    [robot.urdf]
2026-07-28 fix: 恢复堵转检测为2秒(2000ms)，过坎不误判真堵转会停
2026-08-03 docs: 视觉+雷达融合人体跟随设计规格（方案A）
2026-08-03 docs: 视觉跟随实施计划 + 修正角度符号约定(左正右负)
2026-08-03 fix: IMU旋转方向R_z(-π/2)与URDF对齐+姿态四元数roll/pitch互换映射
    - 加速度/角速度: x=+ay,y=-ax (原 x=-ay 导致 EKF ax 取反)
    - 姿态角: base_roll=cf_pitch, base_pitch=cf_roll (绕车头轴/左右轴互换)
    - yaw 无需旋转: Z 轴同向且互补滤波零位与 base 零航向对齐
    [esp32_firmware.ino]
2026-08-03 feat: person_detector YOLOv8n人体检测节点(最中央人选帧+角度换算)
2026-08-03 feat: vision_follower 视觉+雷达融合控制器(3态状态机+摇摆搜索)
    - 审查修复: SEARCH态重置锁定, 回跟随态时重新初始化EMA避免旧目标残留
    [vision_follower.py]
2026-08-03 feat: follow_vision.launch 一键启动 + CMakeLists/SETUP 部署配置
2026-08-03 fix: person_detector 显式CPU推理(device参数), 修复无可用GPU时CUDA崩溃
    [person_detector.py]
2026-08-03 fix: 雷达丢失时只转不前进(防盲目前冲撞墙) + IMU四元数pitch符号修正
    - vision_follower: 抽出 compute_cmd 纯函数, dist=None 时强制 linear.x=0 (规格§6.1)
    - 新增 4 个回归测试 (雷达丢失/距离/角度死区/角度优先)
    - esp32_firmware: half_pitch=-cf_roll, 与 ωy=-imu_gx 自洽 (审查#3)
    [esp32_firmware.ino, vision_follower.py]
2026-08-03 chore: gitignore YOLO 权重文件
2026-08-03 fix: 三方审查共识清单修复
    P0: EKF节点三处重复定义→拆共享odom_ekf.launch单一来源
    imu_calibrated移入accel校准成功分支(失败不再误标已校准)
    P1: WATCHDOG 500→800ms; minimumScore 50→100
    laser_max_beams 60→39(与S9 39点/帧一致); s9 max_range 50→8.0(与amcl一致)
    P2: specs'4态'笔误→3态; bringup 4个死参数删除; plan复选框勾选
    [esp32_firmware.ino, s9_lidar_driver.py]
2026-08-03 fix: ESP32固件显式setBaud(460800)防initNode回落到57600 + 堵转检测改目标转速判断(CMD>=80且实际<1, 5s)
    [esp32_board_test.ino, esp32_firmware.ino]
2026-08-03 fix: S9雷达驱动 距离单位标定(/4000实测) + 角度镜像标定(offset-90) + 定长帧解析防载荷AA55截断 + 15个回归测试
    [s9_lidar_driver.py]
2026-08-03 fix: 视觉跟随雷达断流保护 + costmap插件命名空间修复 + send_goals类型健壮 + 去畸变元数据 + SETUP文档更新
    [scan_deskew.py, send_goals.py, vision_follower.py]
2026-08-03 docs: 添加 AGENTS.md 行为指南
2026-08-03 fix: 串口端口实测校准 — ESP32=ttyUSB1(CP210x) 雷达=ttyUSB0(HL-340), 修正文档与launch默认值
2026-08-03 fix: person_detector YOLO离线加载防联网卡死 + 固件注释记录460800握手经验
    [esp32_firmware.ino, person_detector.py]
2026-08-03 feat: PC端检测可视化工具(view_detection.sh+person_viewer.py) + 持久roscore脚本
2026-08-03 feat: J1900一键启动脚本(j1900_start.sh 数字模式+ESP32自动复位) + SETUP部署步骤全面更新
2026-08-03 fix: ESP32固件降波特率230400+发布33Hz修复位错位(460800握手0xef/cmd_vel被丢弃导致电机不动)
2026-08-03 fix: j1900_start 动态检测端口(CP210x=ESP32, ch341=雷达)防USB插拔后ttyUSB顺序互换
2026-08-04 chore: gitignore 运行时日志目录 .robot_logs/
    Ultraworked with [Sisyphus](https://github.com/code-yeongyu/oh-my-openagent)
2026-08-04 fix: ESP32固件降波特率115200+发布节流(odom 8Hz/IMU 4Hz错峰)+死区补偿实车校准350+零速关STBY
    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
    [esp32_firmware.ino]
2026-08-04 feat: PC端一键启动 robot_start.sh(slam/patrol/follow/stop/status, SSH联动J1900+自动roscore) + 巡航点模板patrol_goals
    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
2026-08-04 refactor: j1900_start.sh 改 base/vision 模式+topic健康检查+115200+systemctl冲突检测; 删除被取代的 nav_start/slam_start/start_roscore
    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
2026-08-04 fix: EKF sensor_timeout 0.35 防雷达/IMU短暂断流导致定位跳变
    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
2026-08-04 docs: README/SETUP 更新 115200 波特率与 robot_start.sh 新启动流程
    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
2026-08-10 feat: person_detector 摄像头倒置旋转180°支持 + follow_vision.launch 参数 + 回归测试
    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
2026-08-10 feat: SLAM一键启动自动打开RViz实时建图窗口 + stop清理rviz进程
    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
2026-08-10 fix: ESP32死区补偿实车校准 350→450(落地起步扭矩不足)
    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
    [esp32_firmware.ino]
2026-08-10 feat: patrol_goals 实机巡航点(RViz选取的真实地图坐标)
    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
2026-08-10 docs: SETUP 标注各步骤执行位置(PC/J1900) + 死区450校准 + RViz建图说明
    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
2026-08-10 docs: 毕业设计论文《基于ROS的两轮差速移动机器人的设计与实现》(含实验图表)
    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
2026-08-18 Update print statement from 'Hello' to 'Goodbye'
2026-08-19 chore: 仓库开源规范化 - 补 .gitignore/License/CI, 清理个人与过时文件
2026-08-19 fix: 固件 rosserial 库入库(可复现编译) + 补全 package.xml 依赖
2026-08-19 docs: README/AGENTS/SETUP 重构为开源展示版 + 架构图与开发指南
2026-08-19 release: v0.1.0 开源整理完成 - OSS 基础设施/测试/CI/硬件图
    - test: 新增 25 例回归测试(36→61): s9 缓冲/跨零 + scan_deskew + send_goals
    - fix: send_goals 畸形条目容错; package.xml 维护者/版本/依赖修复
    - ci: 新增静态检查 job + navfn 依赖 + 并发分组
    - docs: CONTRIBUTING/SECURITY/ARCHITECTURE/PROJECT_STATUS/CHANGELOG + 硬件图(原理图/PCB正反面) + README/AGENTS/SETUP 同步
    [scan_deskew.py, send_goals.py]
2026-08-19 ci: 修复 GitHub Actions 两处真实失败根因
    - ros-test(容器): 容器内默认 shell 是 sh, source 为 bash 内建 →
    'source: not found' exit 127 → 显式 defaults.run.shell: bash
    - python-tests: requirements-dev.txt 缺 PyYAML (send_goals 顶层 import yaml)
    → ModuleNotFoundError exit 2 → 补 PyYAML>=5,<7
    - ros-test 补 python3-numpy/python3-yaml 容器测试依赖
    - actions 升级: checkout v4→v5, setup-python v5→v6 (消除 Node20 弃用警告)
2026-08-23 chore: 忽略论文正文与本地缓存目录
2026-08-23 docs: 新增贡献者行为准则（Contributor Covenant 2.1）
2026-08-23 docs: PR 模板新增辅助工具使用披露项
2026-08-23 docs: 新增英文版 README 并添加语言切换链接
2026-09-09 docs: 更新项目根目录文档(README/SETUP/CLAUDE.md/CURSOR.md/硬件采购清单)
    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
2026-09-09 docs: 毕业设计论文(提交版+技术报告+图表)
    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
2026-09-09 docs: 添加技术文档(架构/维护者流程/项目状态/开发者指南/硬件文档)
    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
2026-09-09 feat: ESP32固件更新(波特率调整+发布节流+死区补偿+ROS库)
    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
2026-09-09 fix: robot_bringup配置更新(EKF超时/巡航点/URDF/包配置)
    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
2026-09-09 feat: robot_bringup launch文件更新(SLAM/导航/跟随/EKF/一键启动)
    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
2026-09-09 feat: robot_bringup脚本更新(一键启动/雷达驱动/视觉跟随/人体检测)
    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
2026-09-09 feat: robot_sim仿真包更新(仿真启动/SLAM/导航/跟随)
    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
2026-09-09 feat: 开发工具更新(雷达测试/检测可视化/架构生成/DXF/SVG)
    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
2026-09-09 test: 添加单元测试(scan_deskew/send_goals)
    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
2026-09-09 chore: 添加GitHub配置(CI/Issue模板/PR模板)
    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
2026-09-09 docs: 添加项目文档(CHANGELOG/LICENSE/CONTRIBUTING/CODE_OF_CONDUCT/SECURITY/英文README)
    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
2026-09-09 docs: 添加硬件采购清单文档
    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
2026-09-09 docs: 移除技术文档和毕业论文
    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
2026-09-09 docs: 恢复技术文档(架构/维护者流程/项目状态/开发者指南/硬件文档)
    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
2026-09-11 docs: README 去表情，改为冷静客观表述
2026-09-11 Simplify PCB image caption in README
    Removed additional text from PCB image caption.
2026-09-11 Simplify PCB back image description
    Updated the description of the PCB back image in the README.
2026-10-12 删除无用文件并恢复 README 引用图
