lawliet206/ROS/(notices)

Notices in the files:
README.md:
License: MIT
